lfiack/gCollector/README.md

# gCollector
Garbage collector robot for FreeRTOS Labs

## How to get the project
This project uses submodules, use the following command to get everything :
```
git clone --recursive git@github.com:lfiack/gCollector.git
```
