lfiack/gCollector/hardware/gc_STM32G491CET6/gc_STM32G491CET6.kicad_pcb

## KiCad design hardware/gc_STM32G491CET6/gc_STM32G491CET6.kicad_pcb (2023-04-14)

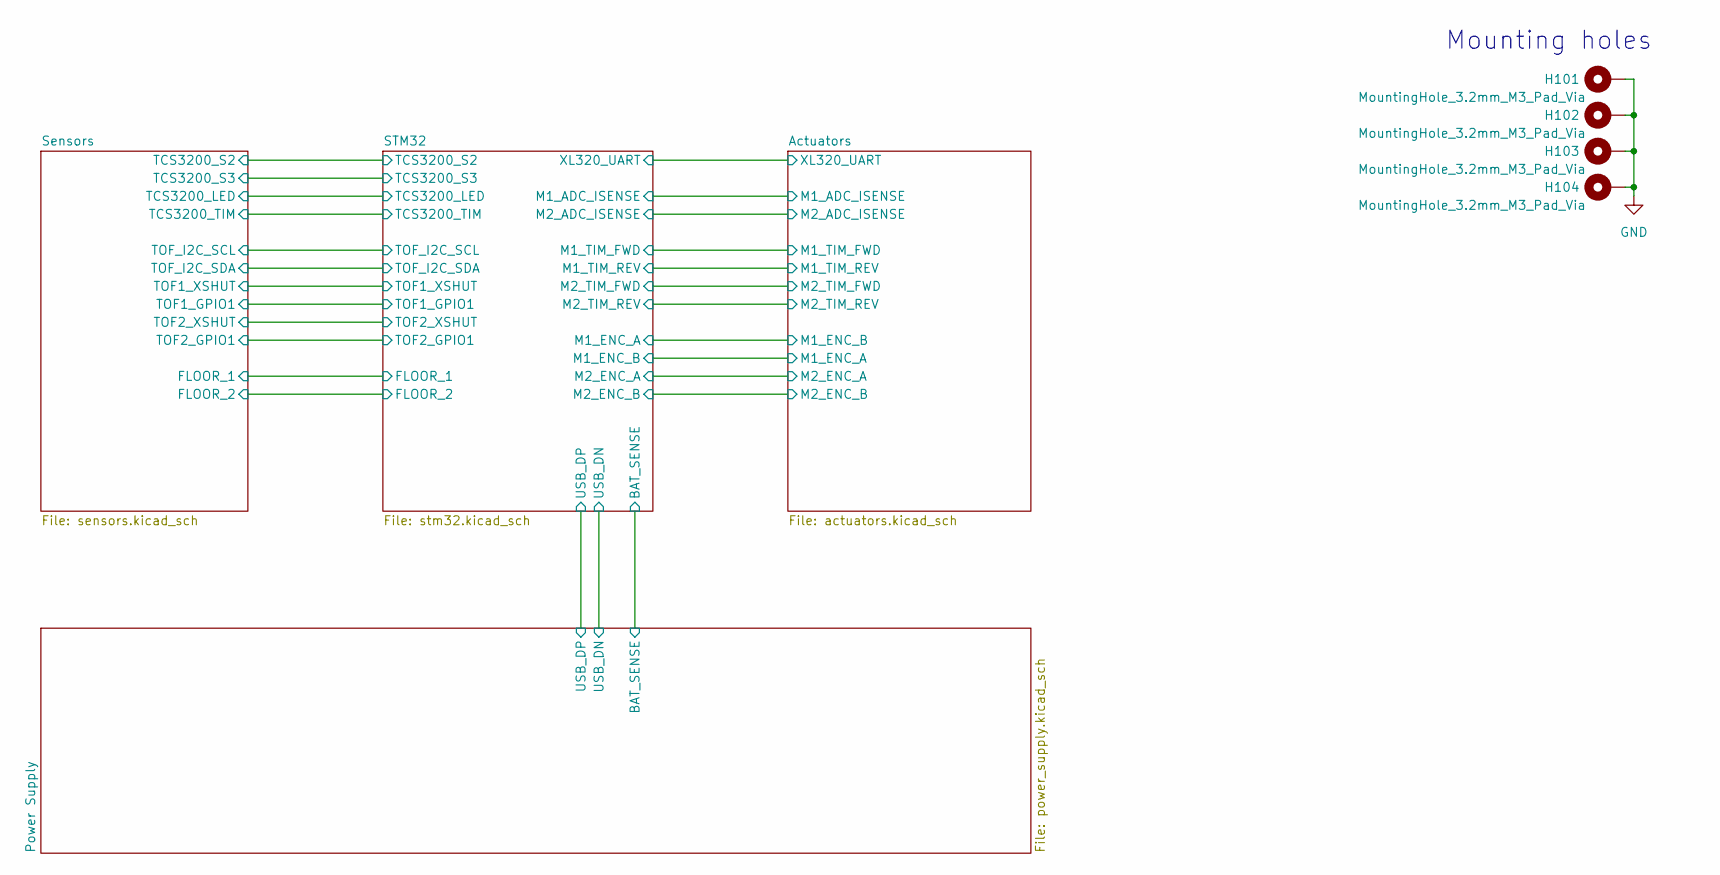
[picture p1: schematic gc_STM32G491CET6.kicad_sch, Robot Bière]

Parts:
H101, H102, H103, H104: MountingHole_3.2mm_M3_Pad_Via

Notes on the sheet:
Mounting holes

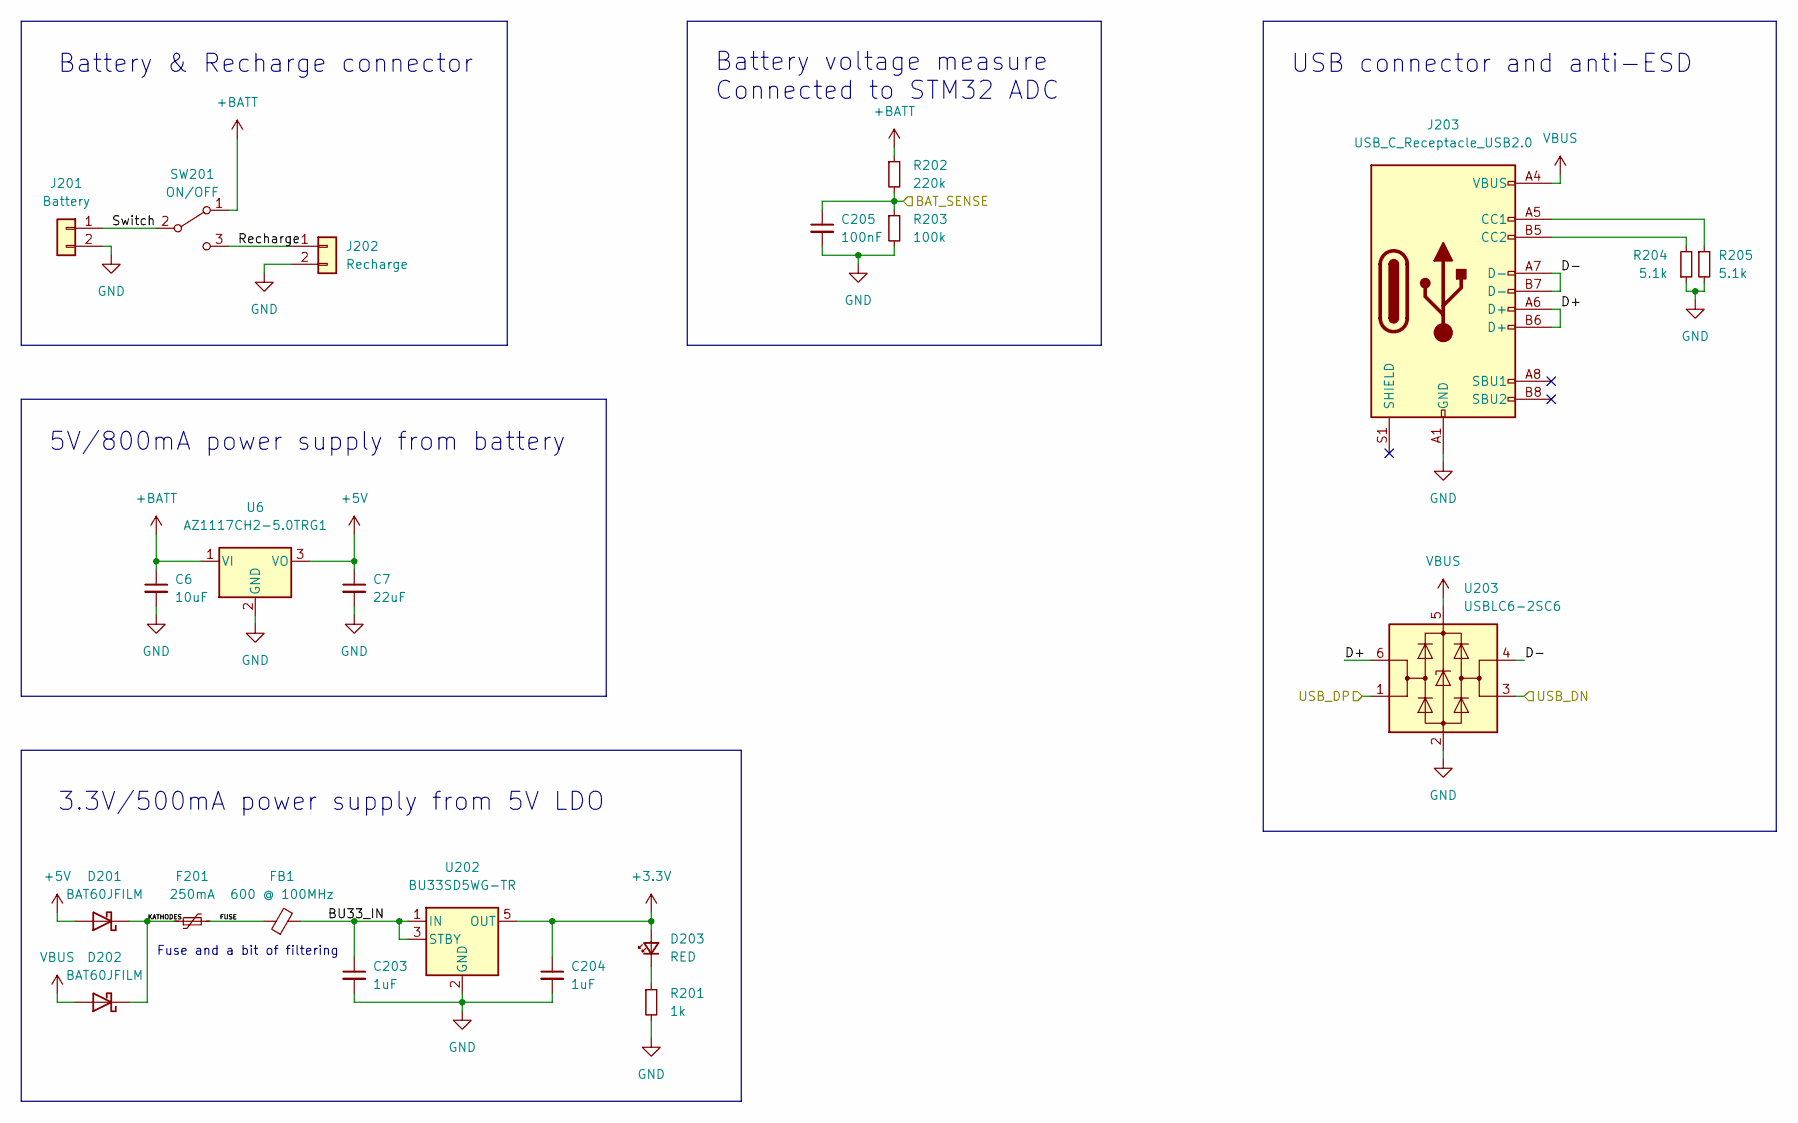
[picture p2: schematic power_supply.kicad_sch]

Parts:
C6: 10uF; C_0603_1608Metric_Pad1.08x0.95mm_HandSolder; Farnell 2113070
C7: 22uF; C_0603_1608Metric_Pad1.08x0.95mm_HandSolder; Farnell 2426957
C203, C204: 1uF; C_0603_1608Metric
C205: 100nF; C_0603_1608Metric
D201, D202: BAT60JFILM; D_SOD-323
D203: RED; LED_0603_1608Metric
F201: 250mA; Fuse_1206_3216Metric_Pad1.42x1.75mm_HandSolder; Farnell 2834880
FB1: 600 @ 100MHz; L_0805_2012Metric_Pad1.15x1.40mm_HandSolder; Farnell 2292460
J201: Battery; JST_XH_B2B-XH-A_1x02_P2.50mm_Vertical
J202: Recharge; JST_XH_B2B-XH-A_1x02_P2.50mm_Vertical
J203: USB_C_Receptacle_USB2.0; USB_C_Receptacle_HRO_TYPE-C-31-M-12
R201: 1k; R_0603_1608Metric
R202: 220k; R_0603_1608Metric
R203: 100k; R_0603_1608Metric
R204, R205: 5.1k; R_0603_1608Metric
SW201: ON/OFF; RS_Switch_448-0747
U6: AZ1117CH2-5.0TRG1; SOT-223-3_TabPin2; Farnell 3942512
U202: BU33SD5WG-TR; SOT-23-5
U203: USBLC6-2SC6; SOT-23-6

Connections:
+3.3V: C204.1, D203.2 (A), U202.5 (OUT); also elsewhere on the board
+5V: C7.1, D201.2 (A), U6.3 (VO)
/Power Supply/BAT_SENSE: C205.1, R202.2, R203.1; also elsewhere on the board
/Power Supply/BU33_IN: C203.1, FB1.2, U202.1 (IN), U202.3 (STBY)
/Power Supply/D+: J203.A6 (D+), J203.B6 (D+), U203.6 (I/O1)
/Power Supply/D-: J203.A7 (D-), J203.B7 (D-), U203.4 (I/O2)
/Power Supply/FUSE: F201.2, FB1.1
/Power Supply/KATHODES: D201.1 (K), D202.1 (K), F201.1
/Power Supply/Recharge: J202.1, SW201.3 (C)
/Power Supply/Switch: J201.1, SW201.2 (B)
/Power Supply/USB_DN: U203.3 (I/O2); also elsewhere on the board
/Power Supply/USB_DP: U203.1 (I/O1); also elsewhere on the board
unnamed: D203.1 (K), R201.1
unnamed: J203.A5 (CC1), R205.1
unnamed: J203.B5 (CC2), R204.2
VBUS: D202.2 (A), J203.A4 (VBUS), J203.A9 (VBUS), J203.B4 (VBUS), J203.B9 (VBUS), U203.5 (VBUS)

Notes on the sheet:
Fuse and a bit of filtering
3.3V/500mA power supply from 5V LDO
Battery & Recharge connector
5V/800mA power supply from battery
Battery voltage measure Connected to STM32 ADC
USB connector and anti-ESD

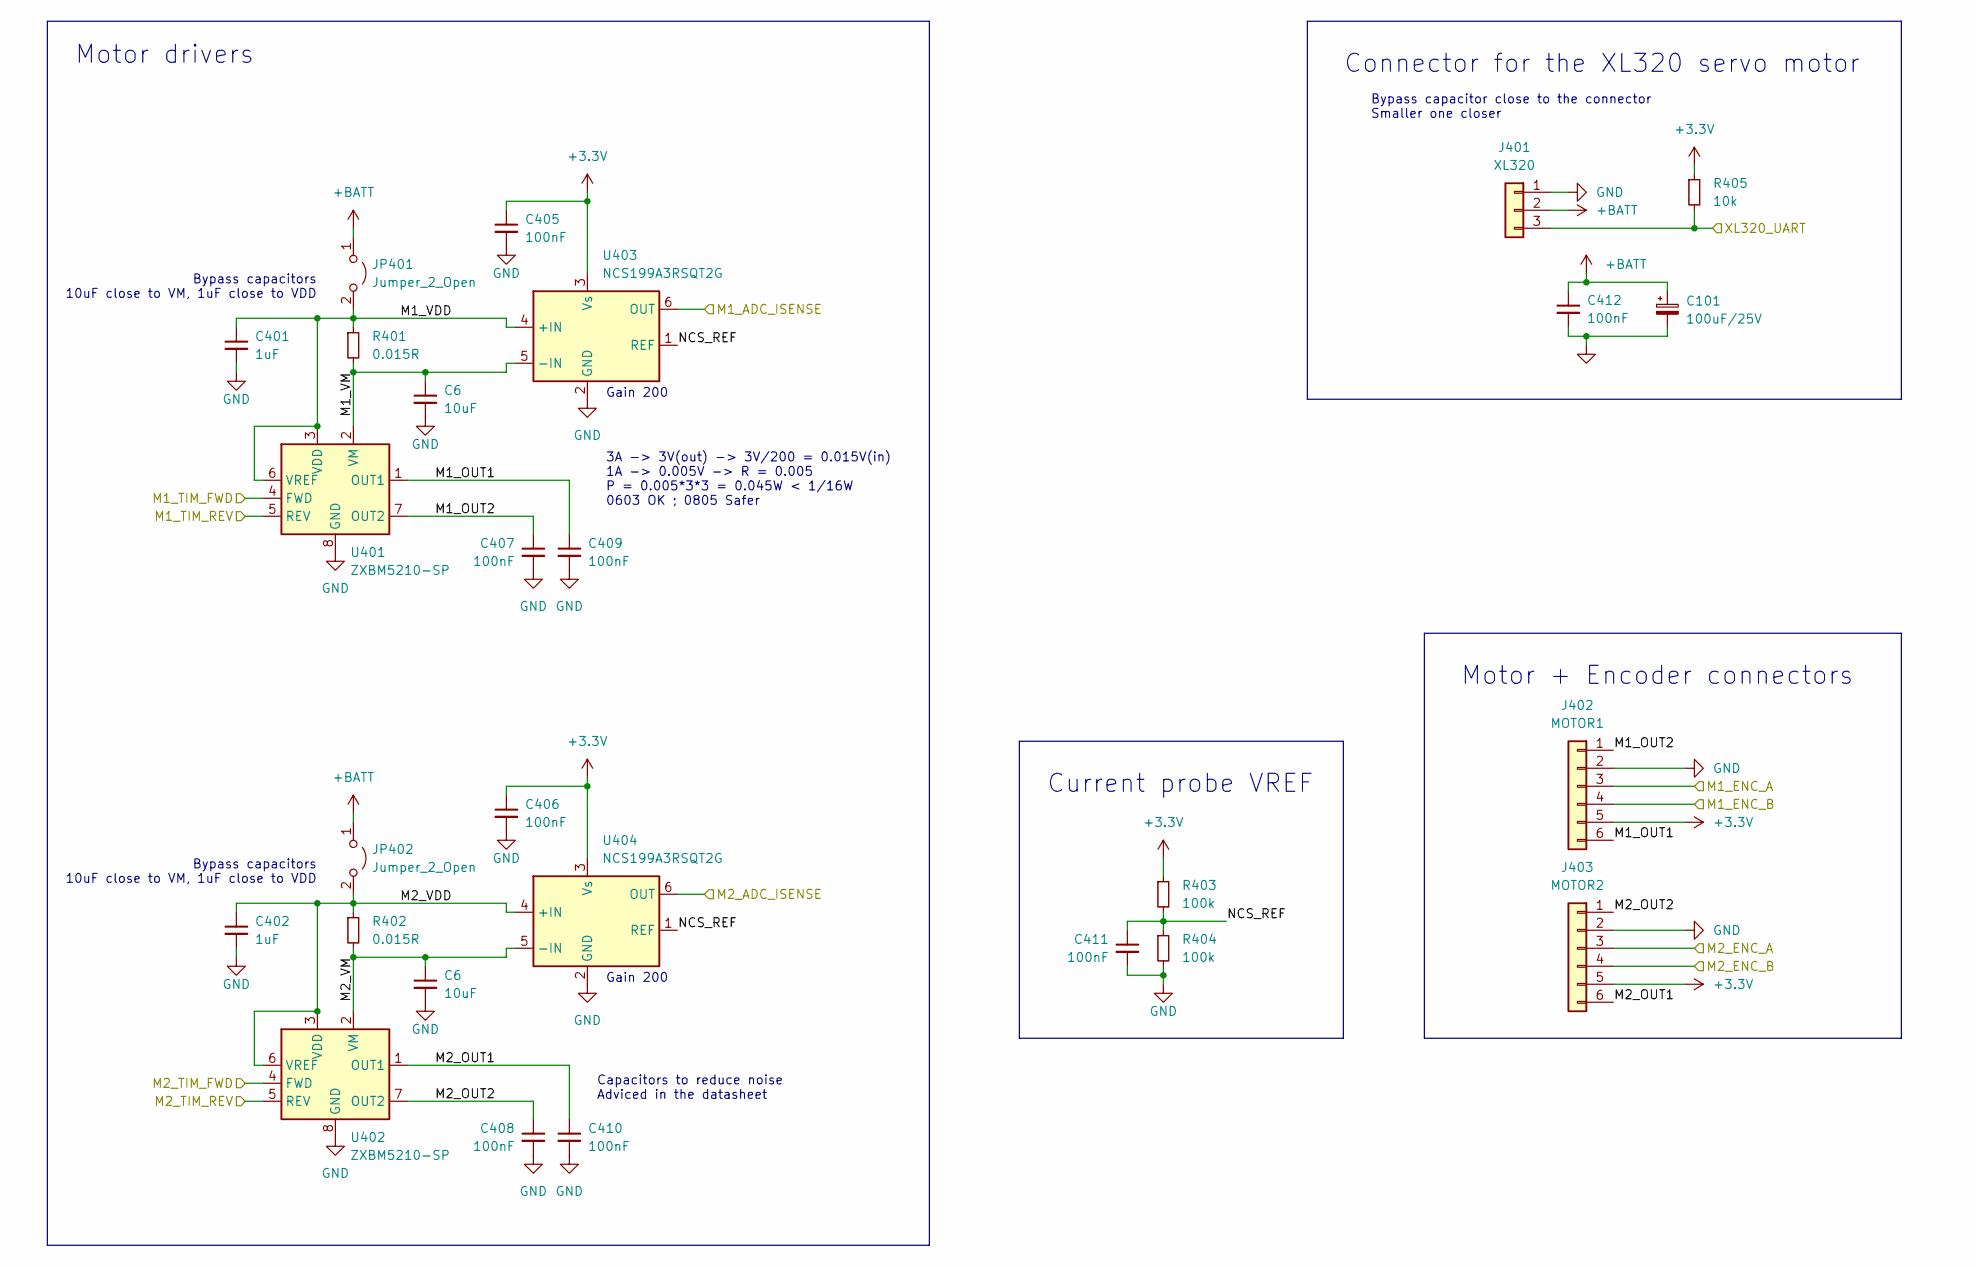
[picture p3: schematic actuators.kicad_sch]

Parts:
C6: 10uF; C_0603_1608Metric_Pad1.08x0.95mm_HandSolder; Farnell 2113070
C101: 100uF/25V; CP_Elec_6.3x7.7
C401, C402: 1uF; C_0603_1608Metric
C405, C406, C407, C408, C409, C410, C411, C412: 100nF; C_0603_1608Metric
J401: XL320; JST_XH_B3B-XH-A_1x03_P2.50mm_Vertical
J402: MOTOR1; JST_XH_B6B-XH-A_1x06_P2.50mm_Vertical
J403: MOTOR2; JST_XH_B6B-XH-A_1x06_P2.50mm_Vertical
JP401, JP402: Jumper_2_Open; PinHeader_1x02_P2.54mm_Vertical
R401, R402: 0.015R; R_0805_2012Metric
R403, R404: 100k; R_0603_1608Metric
R405: 10k; R_0603_1608Metric
U401, U402: ZXBM5210-SP; Diodes_SO-8EP
U403, U404: NCS199A3RSQT2G; SOT-363_SC-70-6; Farnell 2981170

Connections:
+3.3V: C405.1, C406.1, J402.5, J403.5, R403.1, R405.1, U403.3 (Vs), U404.3 (Vs); also elsewhere on the board
/Actuators/M1_ADC_ISENSE: U403.6 (OUT); also elsewhere on the board
/Actuators/M1_ENC_A: J402.3; also elsewhere on the board
/Actuators/M1_ENC_B: J402.4; also elsewhere on the board
/Actuators/M1_OUT1: C409.1, J402.6, U401.1 (OUT1)
/Actuators/M1_OUT2: C407.1, J402.1, U401.7 (OUT2)
/Actuators/M1_TIM_FWD: U401.4 (FWD); also elsewhere on the board
/Actuators/M1_TIM_REV: U401.5 (REV); also elsewhere on the board
/Actuators/M1_VDD: C401.1, JP401.2 (B), R401.1, U401.3 (VDD), U401.6 (VREF), U403.4 (+IN)
/Actuators/M2_ADC_ISENSE: U404.6 (OUT); also elsewhere on the board
/Actuators/M2_ENC_A: J403.3; also elsewhere on the board
/Actuators/M2_ENC_B: J403.4; also elsewhere on the board
/Actuators/M2_OUT1: C410.1, J403.6, U402.1 (OUT1)
/Actuators/M2_OUT2: C408.1, J403.1, U402.7 (OUT2)
/Actuators/M2_TIM_FWD: U402.4 (FWD); also elsewhere on the board
/Actuators/M2_TIM_REV: U402.5 (REV); also elsewhere on the board
/Actuators/M2_VDD: C402.1, JP402.2 (B), R402.1, U402.3 (VDD), U402.6 (VREF), U404.4 (+IN)
/Actuators/NCS_REF: C411.1, R403.2, R404.1, U403.1 (REF), U404.1 (REF)
/Actuators/XL320_UART: J401.3, R405.2; also elsewhere on the board

Notes on the sheet:
Bypass capacitor close to the connector Smaller one closer
Current probe VREF
Motor drivers
Gain 200
Bypass capacitors 10uF close to VM, 1uF close to VDD
Connector for the XL320 servo motor
Capacitors to reduce noise Adviced in the datasheet
Motor + Encoder connectors
3A -> 3V(out) -> 3V/200 = 0.015V(in) 1A -> 0.005V -> R = 0.005 P = 0.005*3*3 = 0.045W < 1/16W 0603 OK ; 0805 Safer

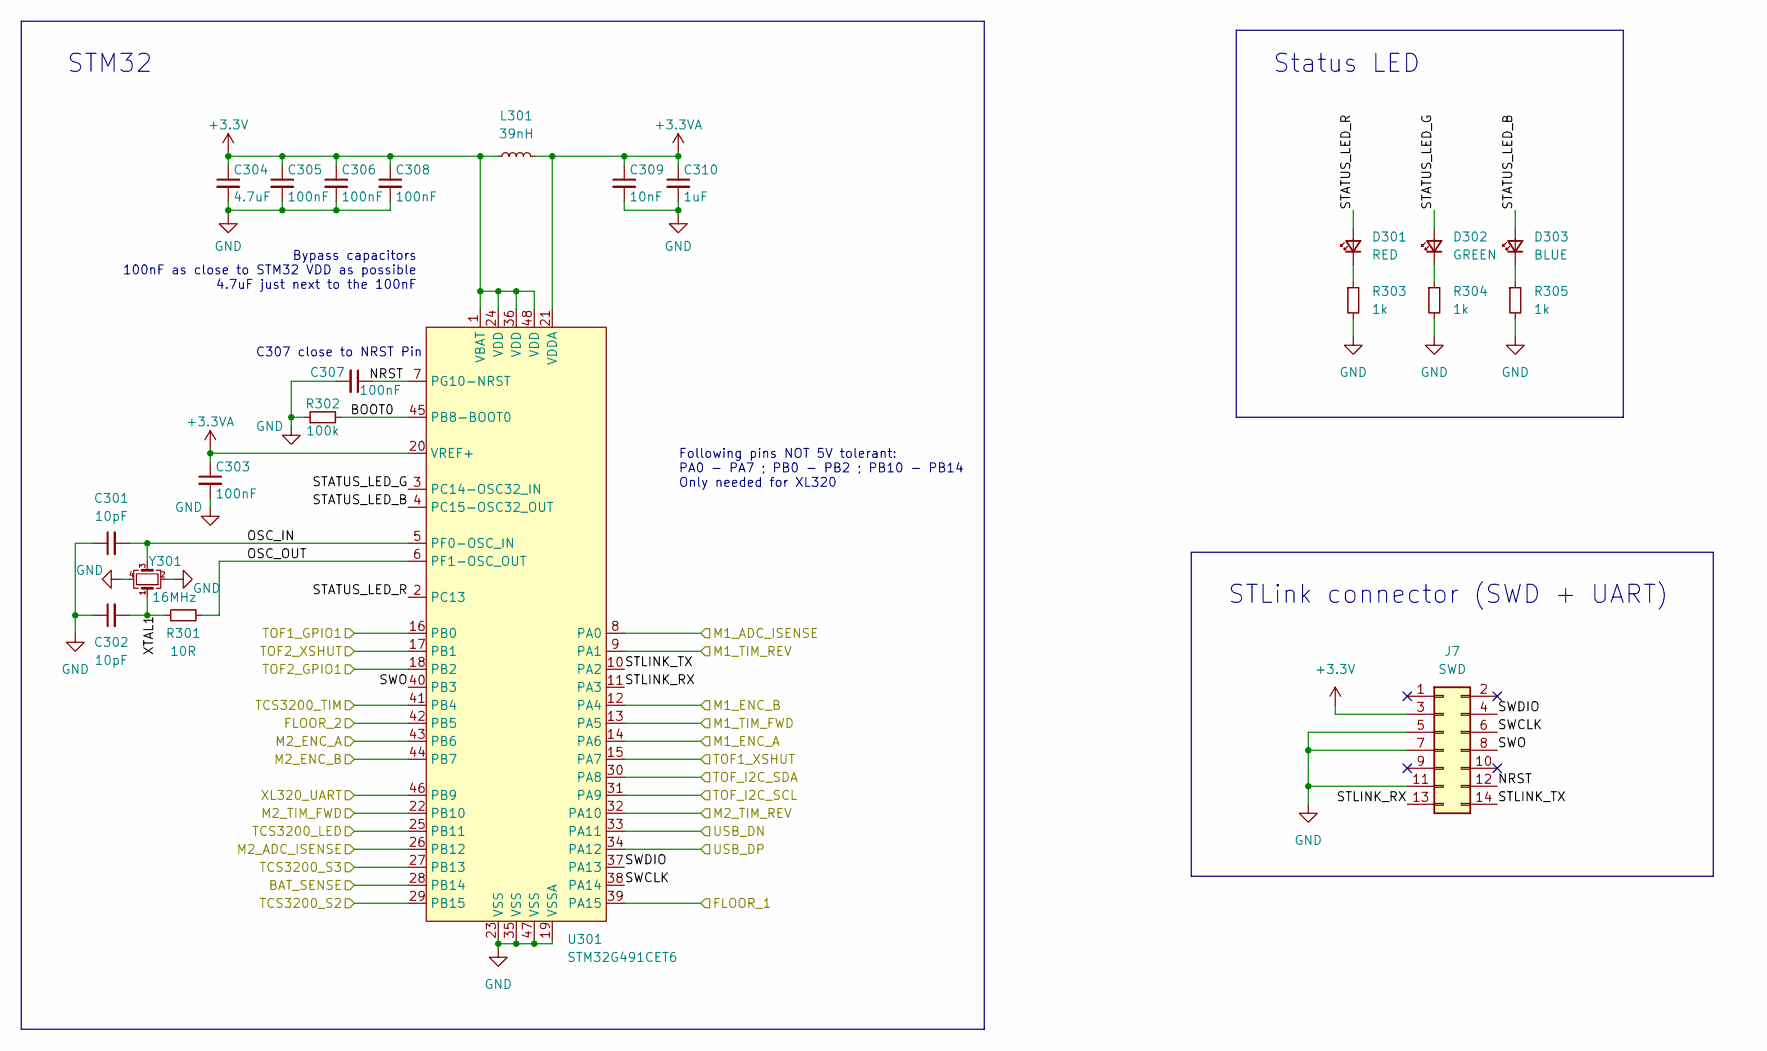
[picture p4: schematic stm32.kicad_sch]

Parts:
C301, C302: 10pF; C_0603_1608Metric
C303: 100nF; C_0603_1608Metric; Farnell 3013398
C304: 4.7uF; C_0603_1608Metric; Farnell 3013398
C305, C306, C307, C308: 100nF; C_0603_1608Metric
C309: 10nF; C_0603_1608Metric
C310: 1uF; C_0603_1608Metric; Farnell 3013398
D301: RED; LED_0603_1608Metric
D302: GREEN; LED_0603_1608Metric
D303: BLUE; LED_0603_1608Metric
J7: Conn_02x07_Odd_Even; PinHeader_2x07_P1.27mm_Vertical_SMD; Farnell 3226055
L301: 39nH; L_0603_1608Metric
R301: 10R; R_0603_1608Metric
R302: 100k; R_0603_1608Metric
R303, R304, R305: 1k; R_0603_1608Metric
U301: STM32G491CET6; LQFP-48_7x7mm_P0.5mm
Y301: 16MHz; Crystal_SMD_EuroQuartz_MT-4Pin_3.2x2.5mm; Farnell 2853935

Connections:
+3.3V: C304.1, C305.1, C306.1, C308.1, J7.3, L301.1, U301.1 (VBAT), U301.24 (VDD), U301.36 (VDD), U301.48 (VDD); also elsewhere on the board
+3.3VA: C303.1, C309.1, C310.1, L301.2, U301.20 (VREF+), U301.21 (VDDA)
/Actuators/M1_ADC_ISENSE: U301.8 (PA0); also elsewhere on the board
/Actuators/M1_ENC_A: U301.12 (PA4); also elsewhere on the board
/Actuators/M1_ENC_B: U301.14 (PA6); also elsewhere on the board
/Actuators/M1_TIM_FWD: U301.13 (PA5); also elsewhere on the board
/Actuators/M1_TIM_REV: U301.9 (PA1); also elsewhere on the board
/Actuators/M2_ADC_ISENSE: U301.26 (PB12); also elsewhere on the board
/Actuators/M2_ENC_A: U301.43 (PB6); also elsewhere on the board
/Actuators/M2_ENC_B: U301.44 (PB7); also elsewhere on the board
/Actuators/M2_TIM_FWD: U301.22 (PB10); also elsewhere on the board
/Actuators/M2_TIM_REV: U301.32 (PA10); also elsewhere on the board
/Actuators/XL320_UART: U301.46 (PB9); also elsewhere on the board
/Power Supply/BAT_SENSE: U301.28 (PB14); also elsewhere on the board
/Power Supply/USB_DN: U301.33 (PA11); also elsewhere on the board
/Power Supply/USB_DP: U301.34 (PA12); also elsewhere on the board
/STM32/BOOT0: R302.2, U301.45 (PB8-BOOT0)
/STM32/FLOOR_1: U301.39 (PA15); also elsewhere on the board
/STM32/FLOOR_2: U301.42 (PB5); also elsewhere on the board
/STM32/NRST: C307.1, J7.12, U301.7 (PG10-NRST)
/STM32/OSC_IN: C301.2, U301.5 (PF0-OSC_IN), Y301.3
/STM32/OSC_OUT: R301.2, U301.6 (PF1-OSC_OUT)
/STM32/STATUS_LED_B: D303.2 (A), U301.4 (PC15-OSC32_OUT)
/STM32/STATUS_LED_G: D302.2 (A), U301.3 (PC14-OSC32_IN)
/STM32/STATUS_LED_R: D301.2 (A), U301.2 (PC13)
/STM32/STLINK_RX: J7.13, U301.11 (PA3)
/STM32/STLINK_TX: J7.14, U301.10 (PA2)
/STM32/SWCLK: J7.6, U301.38 (PA14)
/STM32/SWDIO: J7.4, U301.37 (PA13)
/STM32/SWO: J7.8, U301.40 (PB3)
/STM32/TCS3200_LED: U301.25 (PB11); also elsewhere on the board
/STM32/TCS3200_S2: U301.29 (PB15); also elsewhere on the board
/STM32/TCS3200_S3: U301.27 (PB13); also elsewhere on the board
/STM32/TCS3200_TIM: U301.41 (PB4); also elsewhere on the board
/STM32/TOF1_GPIO1: U301.16 (PB0); also elsewhere on the board
/STM32/TOF1_XSHUT: U301.15 (PA7); also elsewhere on the board
/STM32/TOF2_GPIO1: U301.18 (PB2); also elsewhere on the board
/STM32/TOF2_XSHUT: U301.17 (PB1); also elsewhere on the board
/STM32/TOF_I2C_SCL: U301.31 (PA9); also elsewhere on the board
/STM32/TOF_I2C_SDA: U301.30 (PA8); also elsewhere on the board
/STM32/XTAL1: C302.2, R301.1, Y301.1
unnamed: D301.1 (K), R303.1
unnamed: D302.1 (K), R304.1
unnamed: D303.1 (K), R305.1

Notes on the sheet:
STM32
Bypass capacitors 100nF as close to STM32 VDD as possible 4.7uF just next to the 100nF
Following pins NOT 5V tolerant: PA0 - PA7 ; PB0 - PB2 ; PB10 - PB14 Only needed for XL320
Status LED
STLink connector (SWD + UART)
C307 close to NRST Pin

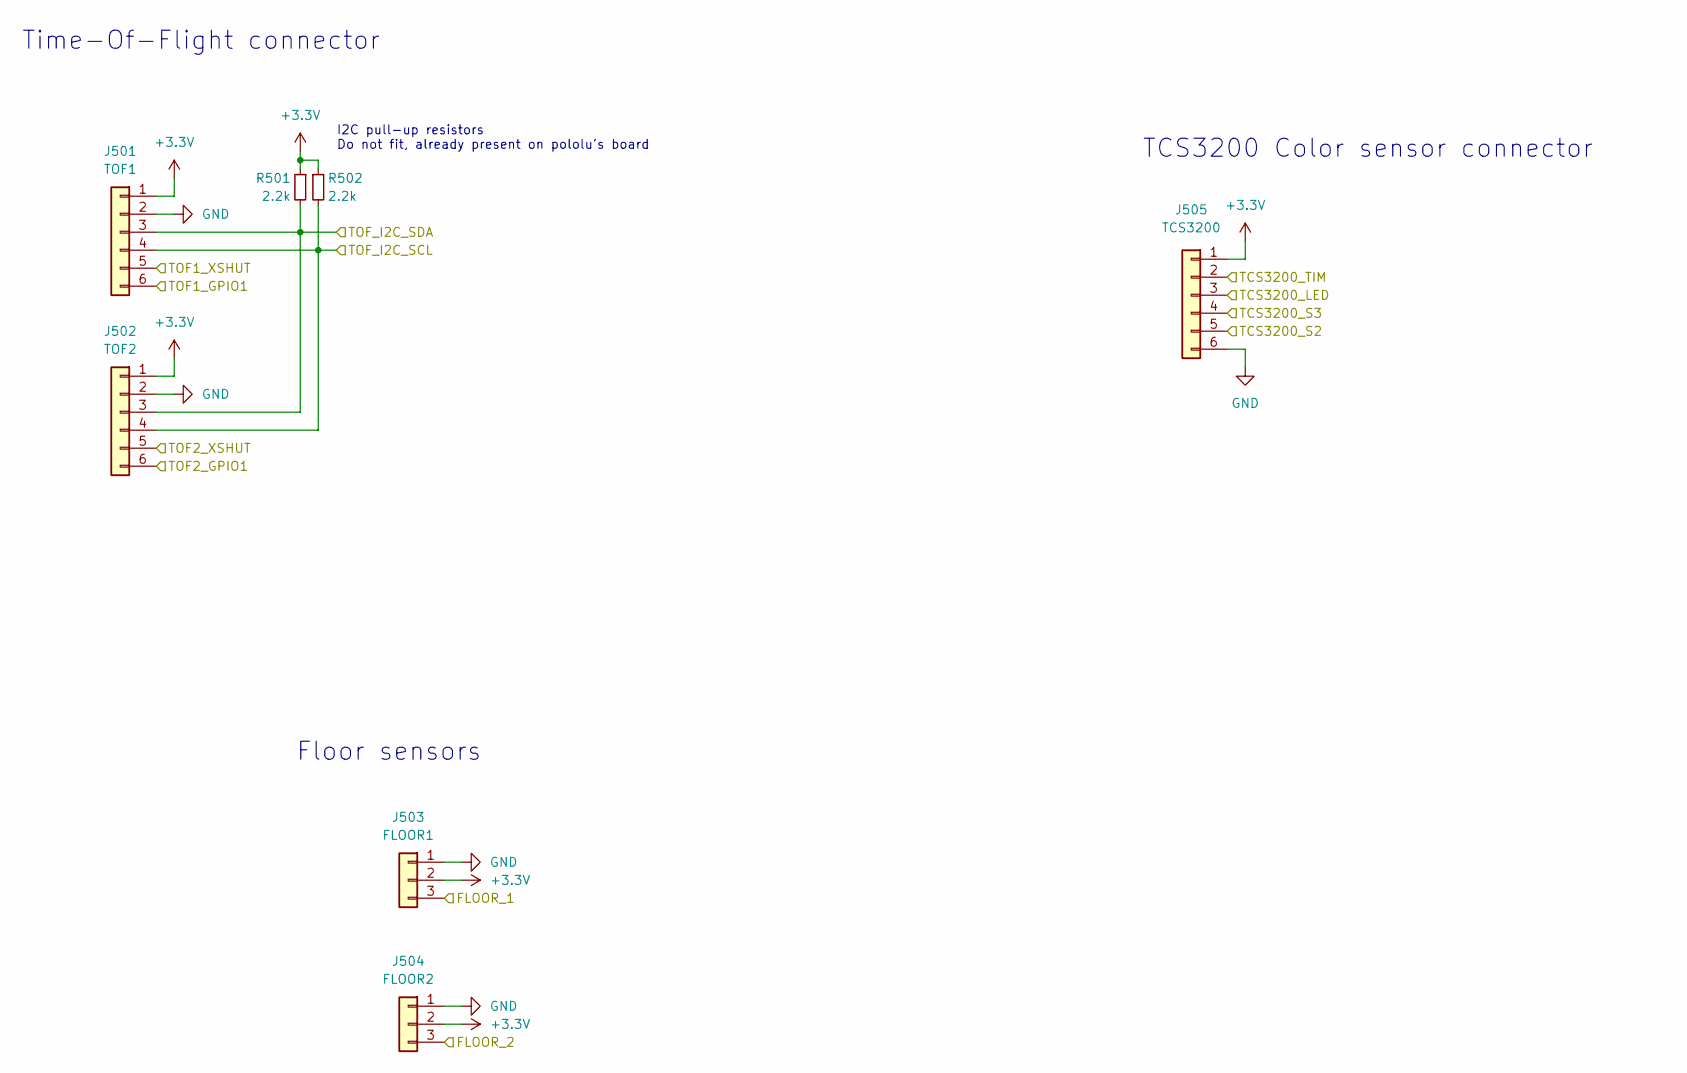
[picture p5: schematic sensors.kicad_sch]

Parts:
J501: TOF1; JST_XH_B6B-XH-A_1x06_P2.50mm_Vertical
J502: TOF2; JST_XH_B6B-XH-A_1x06_P2.50mm_Vertical
J503: FLOOR1; JST_XH_B3B-XH-A_1x03_P2.50mm_Vertical
J504: FLOOR2; JST_XH_B3B-XH-A_1x03_P2.50mm_Vertical
J505: TCS3200; JST_XH_B6B-XH-A_1x06_P2.50mm_Vertical
R501, R502: 2.2k; R_0603_1608Metric

Connections:
+3.3V: J501.1, J502.1, J503.2, J504.2, J505.1, R501.1, R502.1; also elsewhere on the board
/STM32/FLOOR_1: J503.3; also elsewhere on the board
/STM32/FLOOR_2: J504.3; also elsewhere on the board
/STM32/TCS3200_LED: J505.3; also elsewhere on the board
/STM32/TCS3200_S2: J505.5; also elsewhere on the board
/STM32/TCS3200_S3: J505.4; also elsewhere on the board
/STM32/TCS3200_TIM: J505.2; also elsewhere on the board
/STM32/TOF1_GPIO1: J501.6; also elsewhere on the board
/STM32/TOF1_XSHUT: J501.5; also elsewhere on the board
/STM32/TOF2_GPIO1: J502.6; also elsewhere on the board
/STM32/TOF2_XSHUT: J502.5; also elsewhere on the board
/STM32/TOF_I2C_SCL: J501.4, J502.4, R502.2; also elsewhere on the board
/STM32/TOF_I2C_SDA: J501.3, J502.3, R501.2; also elsewhere on the board

Notes on the sheet:
TCS3200 Color sensor connector
Time-Of-Flight connector
Floor sensors
I2C pull-up resistors Do not fit, already present on pololu's board

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
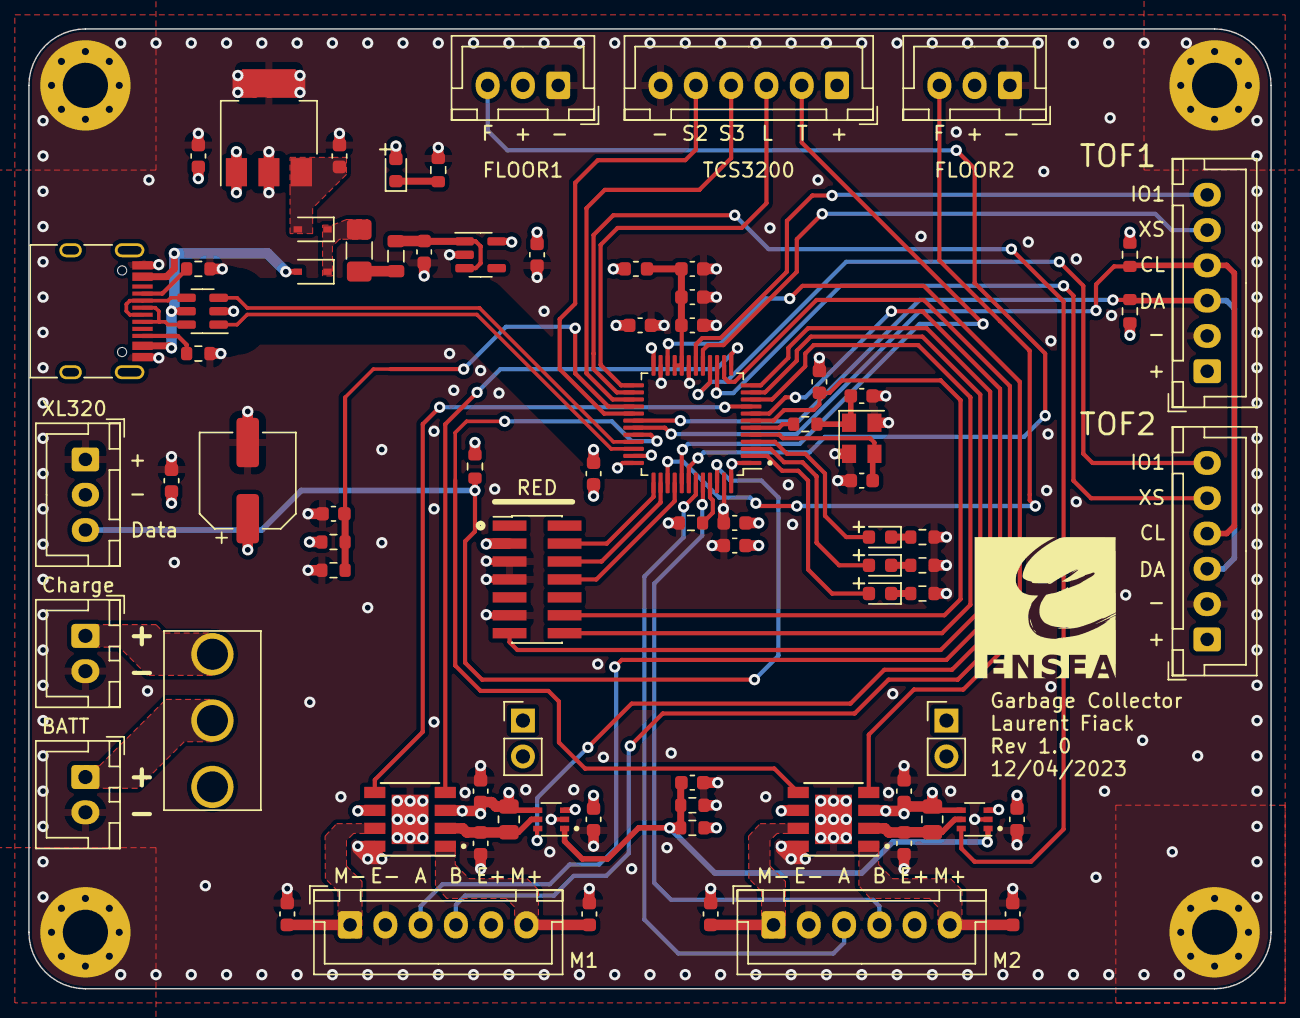
[picture p6: board gc_STM32G491CET6.kicad_pcb from above]

Board: 4 copper layers, 88.0 x 68.0 mm, 82 parts (0 on the bottom side), 67 nets.

Other parts of the board:
C6#2, C6#3: 10uF; C_0603_1608Metric
C413: 100uF/25V; CP_Elec_6.3x7.7
