lfiack/gCollector/hardware/NCS199A3R_test/NCS199A3R_test.kicad_pcb

## KiCad design hardware/NCS199A3R_test/NCS199A3R_test.kicad_pcb (2022-12-06)

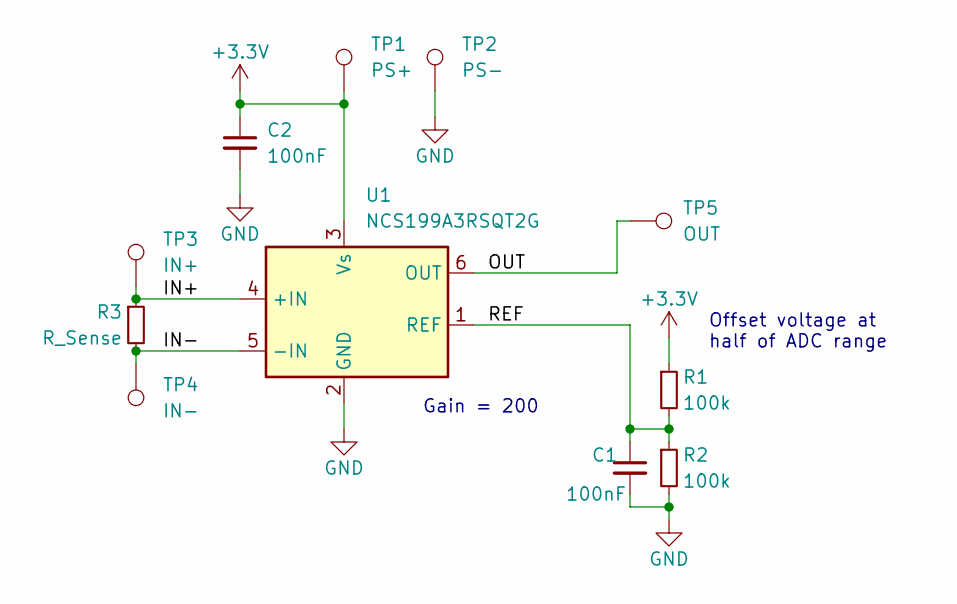
[picture p7: schematic NCS199A3R_test.kicad_sch]

Parts:
C1, C2: 100nF; C_0603_1608Metric_Pad1.08x0.95mm_HandSolder
R1, R2: 100k; R_0603_1608Metric_Pad0.98x0.95mm_HandSolder
R3: R_Sense; R_0805_2012Metric_Pad1.20x1.40mm_HandSolder
TP1: PS+; PinHeader_1x01_P2.54mm_Vertical
TP2: PS-; PinHeader_1x01_P2.54mm_Vertical
TP3: IN+; PinHeader_1x01_P2.54mm_Vertical
TP4: IN-; PinHeader_1x01_P2.54mm_Vertical
TP5: OUT; PinHeader_1x01_P2.54mm_Vertical
U1: NCS199A3RSQT2G; SOT-363_SC-70-6_Handsoldering

Connections:
+3.3V: C2.1, R1.1, TP1.1, U1.3 (Vs)
/IN+: R3.1, TP3.1, U1.4 (+IN)
/IN-: R3.2, TP4.1, U1.5 (-IN)
/OUT: TP5.1, U1.6 (OUT)
/REF: C1.1, R1.2, R2.1, U1.1 (REF)
GND: C1.2, C2.2, R2.2, TP2.1, U1.2 (GND)

Notes on the sheet:
Gain = 200
Offset voltage at half of ADC range

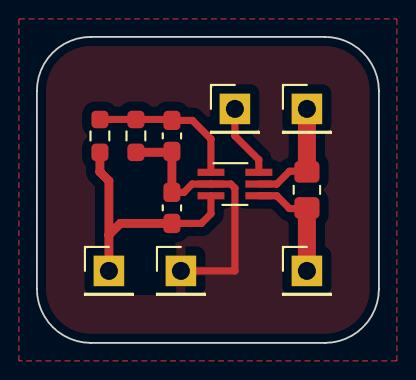
[picture p8: board NCS199A3R_test.kicad_pcb from above]

Board: 2 copper layers, 19.0 x 17.0 mm, 11 parts (0 on the bottom side), 6 nets.
