lfiack/gCollector/firmware/gc_STM32G491CET6/gc_STM32G491CET6.ioc

Mcu.UserName=STM32G491CETx
PA0.GPIO_Label=M1_ADC_ISENSE
PA0.Signal=ADC1_IN1
PA1.GPIO_Label=M1_TIM_REV
PA1.Signal=S_TIM2_CH2
PA10.GPIO_Label=M2_TIM_REV
PA10.Signal=S_TIM2_CH4
PA11.Signal=USB_DM
PA12.Signal=USB_DP
PA13.Signal=SYS_JTMS-SWDIO
PA14.Signal=SYS_JTCK-SWCLK
PA15.GPIO_Label=FLOOR_1
PA15.Signal=GPXTI15
PA2.GPIO_Label=STLINK_TX
PA2.Signal=USART2_TX
PA3.GPIO_Label=STLINK_RX
PA3.Signal=USART2_RX
PA4.GPIO_Label=M1_ENC_B
PA4.Signal=S_TIM3_CH2
PA5.GPIO_Label=M1_TIM_FWD
PA5.Signal=S_TIM2_CH1
PA6.GPIO_Label=M1_ENC_A
PA6.Signal=S_TIM3_CH1
PA7.GPIO_Label=TOF1_XSHUT
PA7.Signal=GPIO_Output
PA8.GPIO_Label=TOF_I2C_SDA
PA8.Signal=I2C2_SDA
PA9.GPIO_Label=TOF_I2C_SCL
PA9.Signal=I2C2_SCL
PB0.GPIO_Label=TOF1_GPIO1
PB0.Signal=GPXTI0
PB1.GPIO_Label=TOF2_XSHUT
PB1.Signal=GPIO_Output
PB10.GPIO_Label=M2_TIM_FWD
PB10.Signal=S_TIM2_CH3
PB11.GPIO_Label=TCS3200_LED
PB11.Signal=GPIO_Output
PB12.GPIO_Label=M2_ADC_ISENSE
PB12.Signal=ADC1_IN11
PB13.GPIO_Label=TCS3200_S3
PB13.Signal=GPIO_Output
PB14.GPIO_Label=BAT_SENSE
PB14.Signal=ADC1_IN5
PB15.GPIO_Label=TCS3200_S2
PB15.Signal=GPIO_Output
PB2.GPIO_Label=TOF2_GPIO1
PB2.Signal=GPXTI2
PB3.Signal=SYS_JTDO-SWO
PB4.GPIO_Label=TCS3200_TIM
PB4.Signal=S_TIM16_CH1
PB5.GPIO_Label=FLOOR_2
PB5.Signal=GPXTI5
PB6.GPIO_Label=M2_ENC_A
PB6.Signal=S_TIM4_CH1
PB7.GPIO_Label=M2_ENC_B
PB7.Signal=S_TIM4_CH2
PB9.GPIO_Label=XL320_UART
PB9.Signal=USART3_TX
PC13.GPIO_Label=LED_R
PC13.Signal=GPIO_Output
PC14-OSC32_IN.GPIO_Label=LED_G
PC14-OSC32_IN.Signal=GPIO_Output
PC15-OSC32_OUT.GPIO_Label=LED_B
PC15-OSC32_OUT.Signal=GPIO_Output
PF0-OSC_IN.Signal=RCC_OSC_IN
PF1-OSC_OUT.Signal=RCC_OSC_OUT
