lfiack/gCollector/firmware/test/test_gcollector/Core/Inc/main.h

#define LED_GREEN_Pin GPIO_PIN_13
#define LED_GREEN_GPIO_Port GPIOC
#define LED_YELLOW_Pin GPIO_PIN_14
#define LED_YELLOW_GPIO_Port GPIOC
#define LED_RED_Pin GPIO_PIN_15
#define LED_RED_GPIO_Port GPIOC
#define M1_TIM_REV_Pin GPIO_PIN_1
#define M1_TIM_REV_GPIO_Port GPIOA
#define STLINK_TX_Pin GPIO_PIN_2
#define STLINK_TX_GPIO_Port GPIOA
#define STLINK_RX_Pin GPIO_PIN_3
#define STLINK_RX_GPIO_Port GPIOA
#define M1_ENC_B_Pin GPIO_PIN_4
#define M1_ENC_B_GPIO_Port GPIOA
#define M1_TIM_FWD_Pin GPIO_PIN_5
#define M1_TIM_FWD_GPIO_Port GPIOA
#define M1_ENC_A_Pin GPIO_PIN_6
#define M1_ENC_A_GPIO_Port GPIOA
#define M2_TIM_FWD_Pin GPIO_PIN_10
#define M2_TIM_FWD_GPIO_Port GPIOB
#define M2_TIM_REV_Pin GPIO_PIN_10
#define M2_TIM_REV_GPIO_Port GPIOA
#define M2_ENC_A_Pin GPIO_PIN_6
#define M2_ENC_A_GPIO_Port GPIOB
#define M2_ENC_B_Pin GPIO_PIN_7
#define M2_ENC_B_GPIO_Port GPIOB
#define XL320_UART_Pin GPIO_PIN_9
#define XL320_UART_GPIO_Port GPIOB
