lfiack/gCollector/(commit log)

2022-12-06 Current probe test board
    [NCS199A3R_test.kicad_pcb, NCS199A3R_test.kicad_sch]
2022-12-21 STM32 sheet
    [actuators.kicad_sch, gc_STM32G491CET6.kicad_pcb, gc_STM32G491CET6.kicad_sch, power_supply.kicad_sch, sensors.kicad_sch, stm32.kicad_sch]
2022-12-23 Schematics + rough placement
    [actuators.kicad_sch, gc_STM32G491CET6.kicad_pcb, gc_STM32G491CET6.kicad_sch, power_supply.kicad_sch, sensors.kicad_sch, stm32.kicad_sch]
2023-04-07 started routing
    [actuators.kicad_sch, gc_STM32G491CET6.kicad_pcb, gc_STM32G491CET6.kicad_sch, power_supply.kicad_sch, stm32.kicad_sch]
2023-04-11 routing V1
    [gc_STM32G491CET6.kicad_pcb]
2023-04-14 tined border
    [gc_STM32G491CET6.kicad_pcb]
2023-05-29 updated witns kicad lib
2023-05-30 update witns kicad lib
