lfiack/gCollector/(notices)

Notices in the files:
firmware/test/test_gcollector/Core/Src/app_freertos.c:
Copyright (c) 2023 STMicroelectronics.
All rights reserved.
This software is licensed under terms that can be found in the LICENSE file
